billkinddev/jarvis-intercom/guide/finished-build.jpg

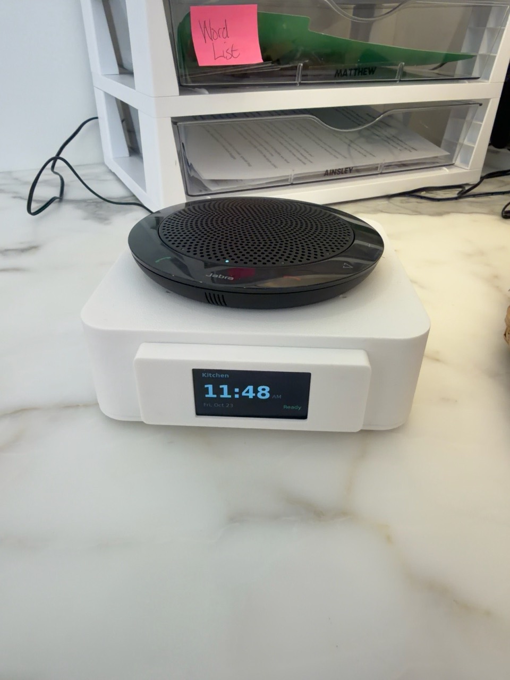
guide/finished-build.jpg
