billkinddev/jarvis-intercom/guide/parts-inventory.png

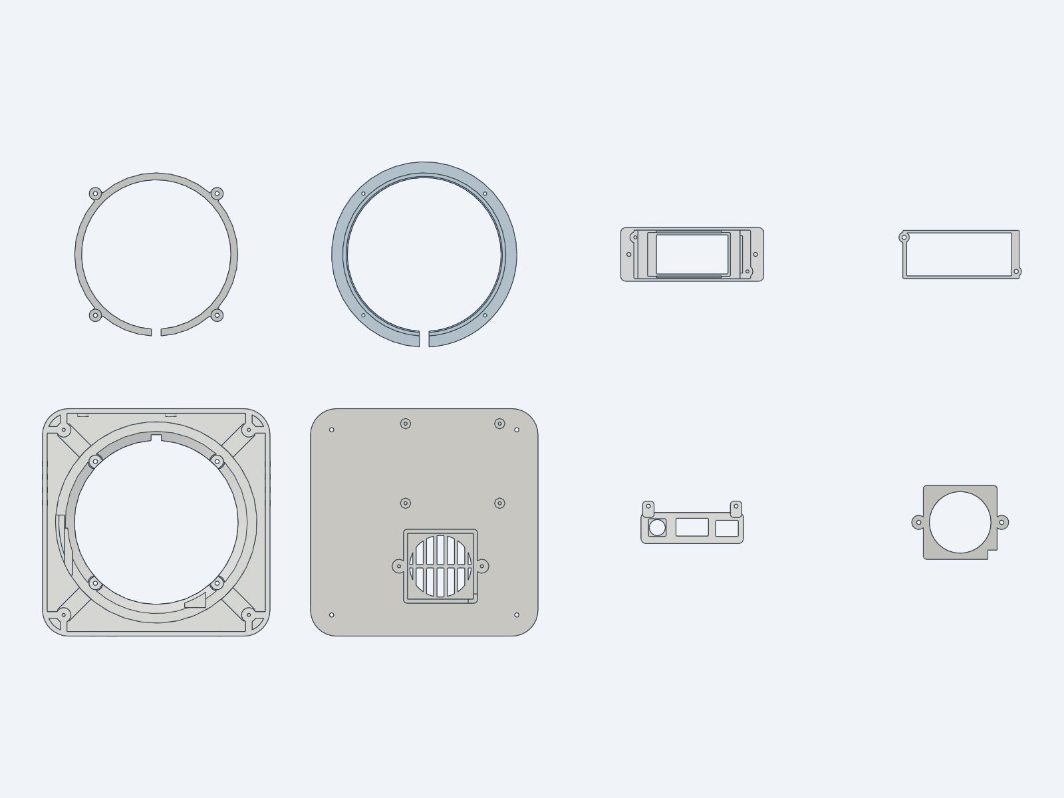
guide/parts-inventory.png
