billkinddev/jarvis-intercom/designs/compact-v3-pi3bplus-r1/STEP/shell.step

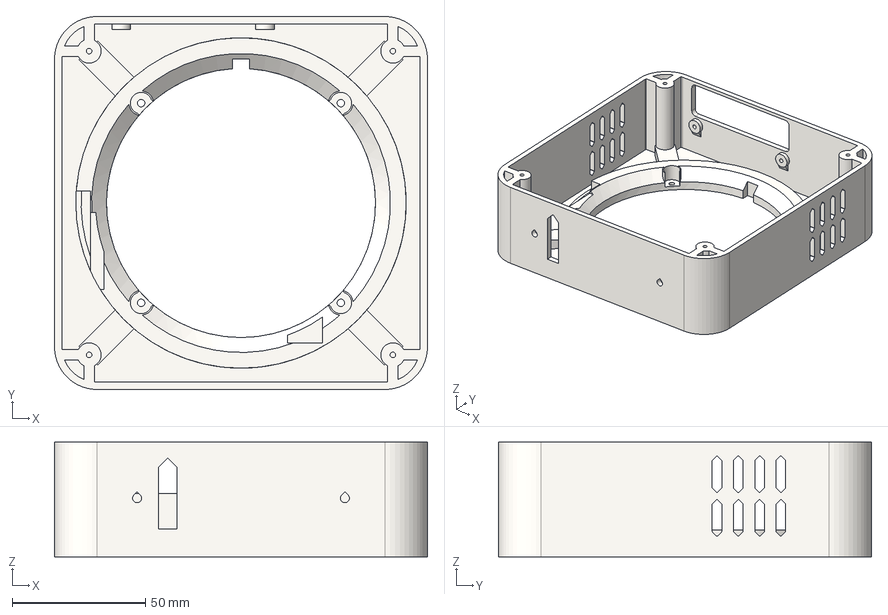
[picture p3: CAD file, 2026-10-23]
designs/compact-v3-pi3bplus-r1/STEP/shell.step
140.0 x 140.0 x 43.0 mm
