billkinddev/jarvis-intercom/designs/compact-v3-pi3bplus-r1/STEP/pi3bplus_rear_insert.step

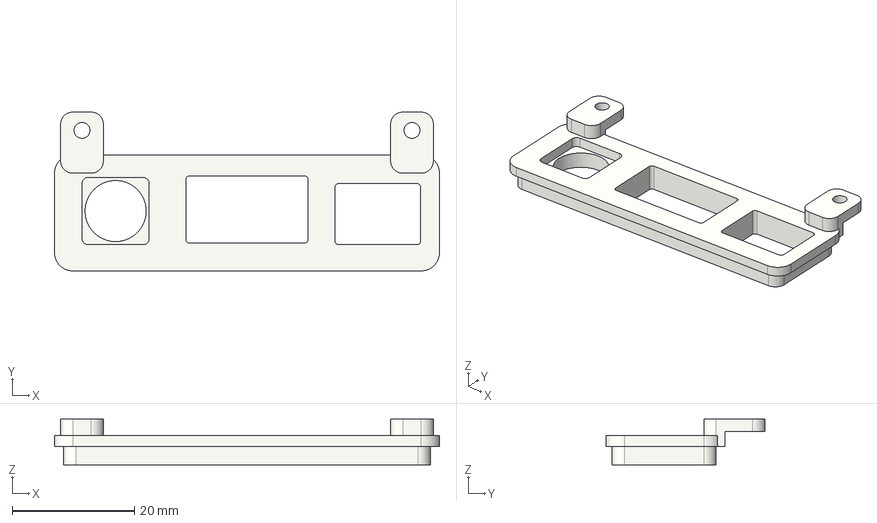
[picture p4: CAD file, 2026-10-23]
designs/compact-v3-pi3bplus-r1/STEP/pi3bplus_rear_insert.step
63.0 x 26.0 x 7.50 mm
