billkinddev/jarvis-intercom/designs/compact-v3-pi3bplus-r1/STEP/base.step

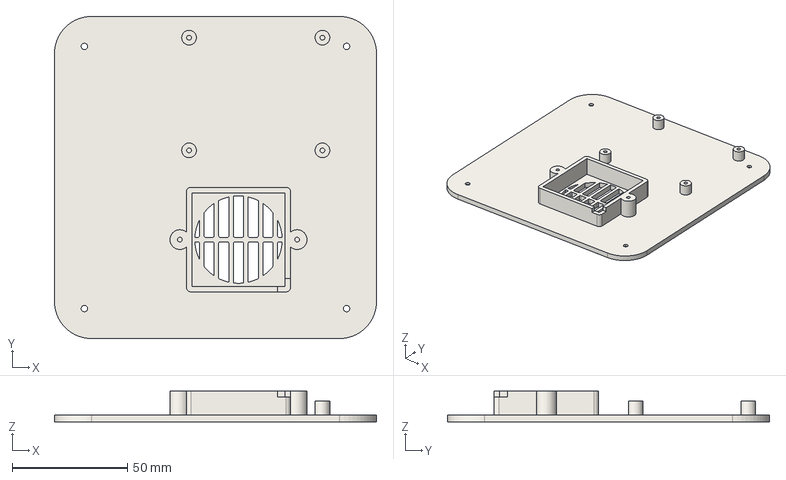
[picture p5: CAD file, 2026-10-23]
designs/compact-v3-pi3bplus-r1/STEP/base.step
140.0 x 140.0 x 13.3 mm
