billkinddev/jarvis-intercom/designs/compact-v3-pi3bplus-r1/STEP/top_ring_2mm_flat_2mm_insertion.step

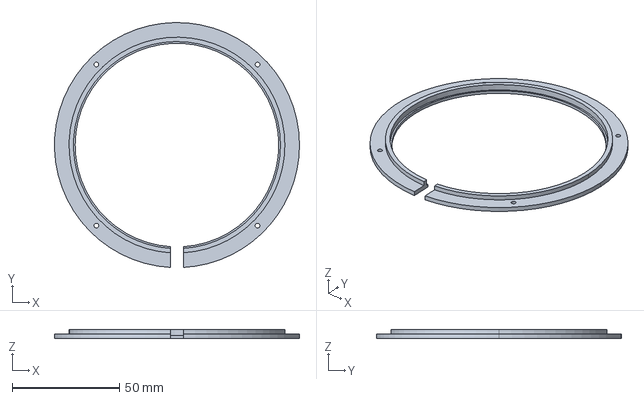
[picture p6: CAD file, 2026-10-23]
designs/compact-v3-pi3bplus-r1/STEP/top_ring_2mm_flat_2mm_insertion.step
114.0 x 113.9 x 4.00 mm
