billkinddev/jarvis-intercom/designs/compact-v3-pi3bplus-r1/STEP/screen_bezel.step

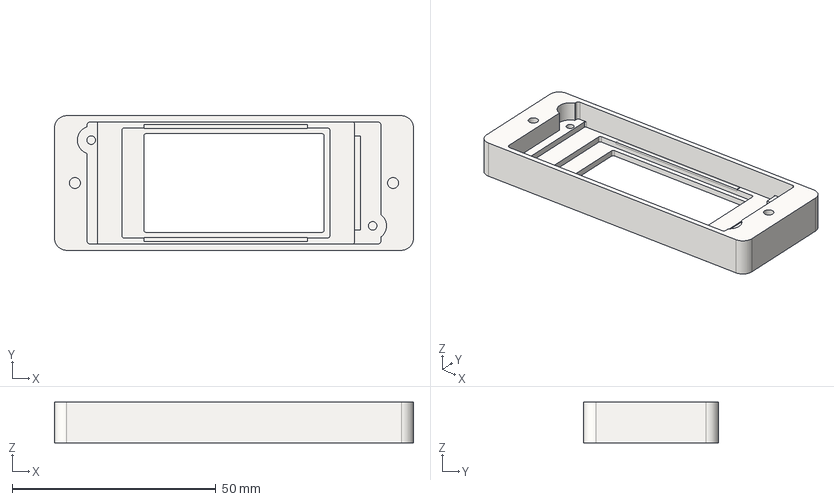
[picture p7: CAD file, 2026-10-23]
designs/compact-v3-pi3bplus-r1/STEP/screen_bezel.step
88.0 x 33.0 x 10.0 mm
