billkinddev/jarvis-intercom/designs/compact-v3-pi3bplus-r1/STEP/lower_jabra_seat.step

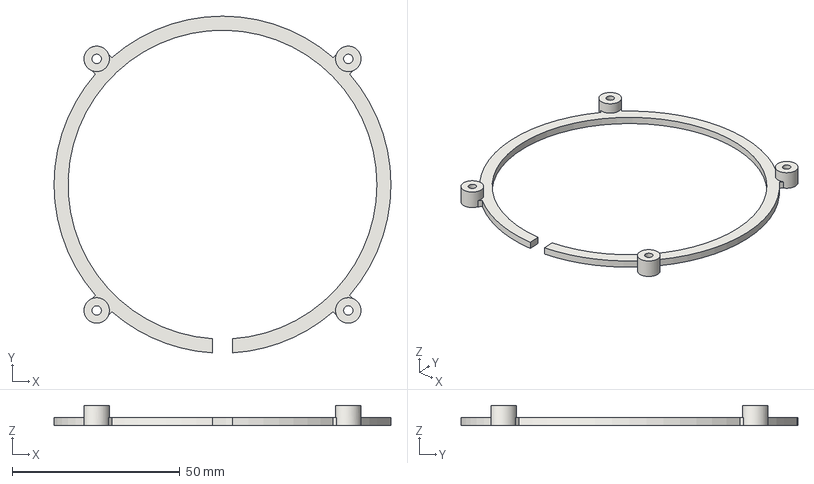
[picture p8: CAD file, 2026-10-23]
designs/compact-v3-pi3bplus-r1/STEP/lower_jabra_seat.step
100.4 x 100.3 x 6.00 mm
