billkinddev/jarvis-intercom/designs/compact-v3-pi3bplus-r1/STEP/screen_retainer.step

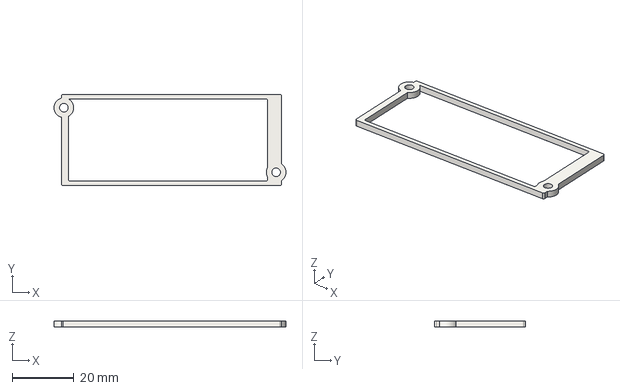
[picture p9: CAD file, 2026-10-23]
designs/compact-v3-pi3bplus-r1/STEP/screen_retainer.step
75.4 x 29.6 x 2.00 mm
