billkinddev/jarvis-intercom/designs/compact-v3-pi3bplus-r1/STEP/fan_retainer.step

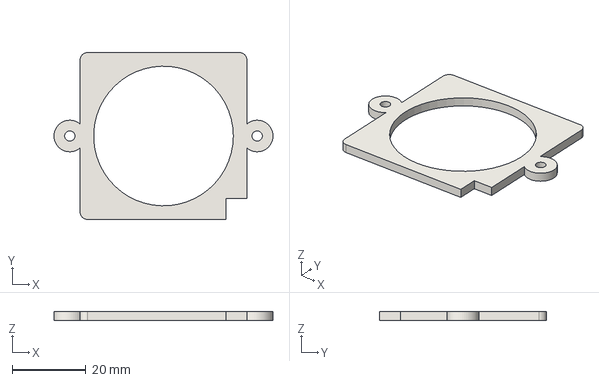
[picture p10: CAD file, 2026-10-23]
designs/compact-v3-pi3bplus-r1/STEP/fan_retainer.step
59.6 x 45.4 x 2.40 mm
