billkinddev/jarvis-intercom/(list of files, cad)

Other CAD files:
designs/compact-v3-pi3bplus-r1/STL/base.stl
designs/compact-v3-pi3bplus-r1/STL/fan_retainer.stl
designs/compact-v3-pi3bplus-r1/STL/lower_jabra_seat.stl
designs/compact-v3-pi3bplus-r1/STL/pi3bplus_rear_insert.stl
designs/compact-v3-pi3bplus-r1/STL/screen_bezel.stl
designs/compact-v3-pi3bplus-r1/STL/screen_retainer.stl
designs/compact-v3-pi3bplus-r1/STL/shell.stl
designs/compact-v3-pi3bplus-r1/STL/top_ring_2mm_flat_2mm_insertion.stl
