billkinddev/jarvis-intercom/guide/index.html

Jarvis Intercom / Build notesCompact v3 · October 2026

A DIY room-to-room intercom

# Jarvis Intercom.

“Hey Jarvis, call the office.”
A Raspberry Pi, a proper speakerphone, and a case built around everyday use.

Local wake + command recognitionSIP calling3D-printed enclosure

Explore in 3D ↘Get the design files

Jarvis Intercom, built and running. Actual photo of the finished Kitchen station.

140 × 140 mmMain enclosure footprint

46 mmBody height; excludes Jabra, bezel and pads

8 printed partsMatched Pi 3 B+ reference kit

1.9″ status displayClock, room and call state; no touch

01 / What it does

## A small intercom for the house.

Say the wake phrase, wait for the beep, then ask to call a room. Or press the Jabra’s green button to start a command. Incoming calls can ring for an answer or connect automatically, with an optional arrival chime. The screen shows the time and who the station is calling.

The useful shortcut

### Keep the conference speakerphone.

The Jabra provides the microphone, speaker, buttons and audio processing in one USB device. We kept those strengths and built a smaller, serviceable enclosure around the Pi and display.

### Built for calling

Local wake detection and a small call vocabulary keep the interaction focused. The current build is an intercom, not a general conversational assistant. There is no cloud speech-recognition dependency for the wake phrase or room commands.

What this page shares: the working system’s design approach, the frozen Pi 3 B+ geometry set, wiring and reference settings. The application is still a private project; there is no public one-click installer or ready-made SD image in this download.

02 / Hardware

## The parts inside.

This reference version uses a Pi 3 B+. A Pi 4 station also exists, but its power connector and rear insert differ. Use the matching geometry for the board you actually have.

Part | Quantity | Reference build / purpose
Raspberry Pi 3 Model B+ | 1 | 1 GB RAM, Wi-Fi, full 40-pin header. Runs headless with Raspberry Pi OS Lite 64-bit.
Jabra Speak 410 USB speakerphone | 1 | Connected by USB inside the enclosure. Confirmed audio/control model; similar-looking Jabra models are not automatically interchangeable.
1.9-inch ST7789 IPS module | 1 | 170 × 320 pixels, 8-pin SPI, labels GND / VCC / SCL / SDA / RES / DC / CS / BLK. Status display, not a touchscreen.
GeeekPi / 52Pi F-0011 fan | 1 | 5 V, 40 × 40 × 10 mm, red power / black ground / blue control. Fits the base pocket with a printed retainer.
MicroSD card | 1 | 32 GB class used for the reference setup.
Micro-USB power supply | 1 | Quality regulated supply. The official Pi 3 supply is 5.1 V / 2.5 A. A 5 V / 1 A adapter is undersized for this combined build.
Female-to-female jumper leads | 8 | For the display; the fan has its own three leads. Leave enough slack to open the base.
Heatsink, rubber pads, fasteners | 1 set | Low-profile Pi heatsink with clearance; pads that leave roughly 6–8 mm underneath; joint-specific screws below.
Printed kit | 8 parts | White PLA reference prints. Individual STL and STEP files are bundled below.
Shared call server | 1 per system | A separate always-on Linux machine runs Asterisk. The reference system uses a Pi 5 for central services.

Hardware references: Pi 3 B+ (https://www.raspberrypi.com/products/raspberry-pi-3-model-b-plus/) · Official power supply (https://www.raspberrypi.com/products/micro-usb-power-supply/) · F-0011 fan specification (https://wiki.52pi.com/index.php?title=F-0011).

Fastener list and where each screw goes

Joint | Hardware | Direction / receiving feature
Base to shell | 4 × M2.3 × 12 mm self-tapping | From underside through recessed head seats into shell pilots. No nuts.
Pi to base | 4 × M2.3 × 6 mm self-tapping | Through PCB mounting holes into printed pilots. Snug by hand.
Fan retainer | 2 × M2.3 × 8 mm self-tapping | Through the retainer into pocket posts, outside the fan housing.
Rear insert | 2 × M2.3 × 6 mm self-tapping | From inside the empty shell.
Screen retaining frame | 2 × M2.5 × 6 mm | From rear frame into bezel. Do not substitute 8 mm screws; front skin is thin.
Bezel to shell | 2 × M3 × 10 mm | From inside the shell into the bezel.
Thin top ring / lower seat | 4 matching screws; length still to verify | The 2 mm ring changes engagement. The old thicker-collar M2.5 × 12 mm length is not a specification for this ring.

The ring’s screw length is the remaining gap in the frozen kit’s hardware record. Check actual engagement and clearance before tightening; do not force an inherited screw length into the thin ring.

03 / The matched design

## Explore the build in 3D.

Rotate the assembly, slide the pieces apart, or hide the shell to see inside. Choose “Only this” to inspect one piece. The eight printed meshes match the downloadable kit; hardware is illustrated with simplified shapes.

EXPLORE THE DESIGN

### Every piece, inside and out.

Perspective view

Drag to rotate · Scroll or pinch to zoom · Arrow keys rotate

All pieces are hidden.

Show all pieces

Explore

Exploded assemblySeparation 0%Open assemblyCutaway (visual only)Show hardware

Cut axis Cut position

Viewpoint

FrontRearLeftRightTopBottomReset

Zoom +Zoom −

## Pieces

Show all

Uncheck to hide. Choose Only this to inspect a piece on its own.

Hardware & cables

Key dimensions

CAD pieces use the supplied design meshes. Hardware, if shown, represents approximate envelopes. Cutaway and exploded motion explain the assembly; they do not verify physical fit or collision clearance.

Compact enclosure v3 / Pi 3 B+ / flat 2 mm ring / r1. The thin ring is shown in its nominal position on the top deck; the viewer does not establish screw engagement or clearance.

See the flat inventory of all eight printed pieces

Show complete kit

Orthographic inventory view, not an assembled model or a ready-to-print plate. Units: millimeters.

Reference kit

### One of each.

The shell, base, speaker retention, screen mount and board-specific rear insert stay together as a matched revision.

1Shell2Base3Pi 3 B+ rear insert4Fan retainer5Lower Jabra seat6Flat 2 mm top ring7Screen bezel8Screen retainer

### Keep the Jabra exposed

The flat ring has a 2 mm flange and a further 2 mm insertion wall. A single cable split routes the cord. The speakerphone’s top, touch controls and side openings remain exposed.

### Make the base serviceable

The 40 mm fan sits ahead of the Pi in a 40.6 mm pocket. A separate bracket retains its housing. The removable rear insert matches the Pi 3’s micro-USB, full-size HDMI and audio sockets.

04 / Print settings

## Orient for the finish. Support selectively.

The reference prints used white PLA, 0.4 mm nozzles and 0.20 mm layers. The shell printed on a Snapmaker U1; base and small-part work used a FlashForge Adventurer 5M Pro. These are recorded settings, not G-code for another printer.

Part / recorded job | Orientation | Walls / infill | Support / adhesion
v3 shell | Cosmetic top face on the bed | 4 walls; 25% grid | Manual support beneath the rear opening roof. No support filling the Jabra center, vents or screw holes. No brim in the Oct 19 job.
Base + fan retainer | Base underside down; fan pocket walls upward. Retainer flat. | 4 walls; 25% grid | No supports and no brim in the recorded Oct 19 toolpath.
Selected flat top ring | Flat flange on the bed | 4 walls; 15% grid | No supports. 3 mm outer brim, 0.1 mm separation in the actual Oct 20 G-code.
Rear insert + screen parts + lower seat | Retain exported orientations; inspect in slicer | 0.20 mm / 4 walls as a starting point | Local insert flange / ear support may be required. Inspect screen locating features and keep terminals, pilots and accessible faces clear.

Recorded temperatures, speeds and time estimates

Shell: 220°C nozzle / 60°C bed; 0.24 mm first layer, five top and ten bottom layers; 0.20 mm support Z gap, 0.35 mm XY gap; rear seam. First-layer walls 50 mm/s, infill 105 mm/s. Outer-wall preset 200 mm/s. The saved shell + older Pi 4 insert job estimated 4h 25m / 160 g, so that is not an exact Pi 3 full-kit time.

Base + fan retainer: 220°C nozzle; bed 60°C first layer, then 55°C; 0.20 mm first layer; five top / three bottom layers; first-layer walls 20 mm/s, infill 30 mm/s. Saved estimate 2h 46m / 57.7 g.

Ring: 220°C nozzle; bed 60°C first, then 55°C; first-layer walls and infill 20 mm/s; initial acceleration 300 mm/s². The recorded 39-minute job contained two trial rings, not one final ring.

About surface lines: these saved jobs did not use a special slow outer-wall profile. A slower exterior is a tuning experiment, not an already-proven setting here. Start from your printer’s calibrated profile and compare a short sample before repeating the full shell.

A later two-printer batch was prepared but not printed. Its revised screen bezel and slice estimates are not treated as build validation. The download contains unsliced geometry only.

Preview the toolpaths around the actual features. Earlier automatic supports clogged nut pockets and left exterior scars. The newer base avoids those nut traps, and supports on the shell are confined to accessible, mostly hidden areas. This is not a claim that every part prints without support.

05 / Assembly

## Build from the open shell outward.

Disconnect power before fitting the electronics or changing wiring. Check fit without screw pressure first. The checks below are session notes for the builder, not automatic verification.

0 of 6 checks markedReset checks

STEP 01

### Clean and identify the printed parts

Remove brim and the deliberately placed rear-opening supports. Check the pilots, grille and port openings. Match all eight parts to the kit above, including the Pi 3 rear insert and the flat 2 mm ring.

Do a dry fit of the base and rear insert before installing electronics. Avoid twisting fragile locating features while removing support.

Parts match and mating surfaces are clear.

STEP 02

### Fit the rear insert and display

In the empty shell, install the board-specific rear insert. Seat the ST7789 in the front bezel; fit the rear retaining frame at the PCB edges. Attach the bezel from inside the shell.

If the header end sits high, stop. Do not use the screws to pull it flat. A later pin-clearance bezel revision is still fit-pending and is not silently substituted into this frozen download.

Screen sits flat with clearance for pins and solder joints.

STEP 03

### Seat the Jabra and align the cable split

Align the Jabra cord with the split in the top ring and lower seat. Keep the side openings and buttons clear. Use the four retention positions, checking actual screw engagement for this thinner ring.

The old thicker-collar screw length has not been validated for this ring. Confirm that detail before closing the build.

Jabra is secure without pressure on its controls or cord.

STEP 04

### Mount the fan and Pi on the base

Point the fan’s airflow arrow upward into the enclosure. Route its wires through the corner exit and fit the retainer without bending the housing. Mount the Pi with its power, HDMI and audio sockets facing the rear insert; USB-A/Ethernet face inward.

Fan blades turn freely; board and rear ports line up.

STEP 05

### Connect and bench-test

Plug the Jabra into USB-A. Connect the display and fan using the interactive map below. Leave service slack for opening the base; route it away from blades, screw posts and the closing seam.

With the base accessible, power on and confirm the screen, USB audio and software readiness. A stopped temperature-controlled fan is normal below its threshold.

Wiring checked at both ends and powered functions tested.

STEP 06

### Close, raise and test in the room

Shut down and unplug again. Close the base with its four recessed screws. Place rubber pads near the corners, leaving both the intake and closure screws accessible.

Test wake detection at the usual distance, two-way calls, repeated green/red/mute use and a restart. Compare fan noise and temperatures in the actual enclosure.

Clear intake, no trapped cables, room test completed.

06 / Wiring

## Eleven connections. One at a time.

The diagram uses physical header pin numbers, with the Pi viewed from the component side. GPIO18 is physical pin 12. Match display labels rather than guessing from jumper color.

REFERENCE WIRING · PI 3 B+

### Connect the status screen and controlled fan

1.9-inch ST7789, 170 × 320 pixels · GeeekPi F-0011 5 V fan

Shut down the Pi, then unplug its power before wiring.
Every number below is a physical header pin. The display uses 3.3 V only; never connect its VCC or BLK to 5 V.

#### 1. Turn the Pi this way

Components facing you. GPIO header at the top. USB and Ethernet ports on the right. Pin 1 is at the left end, on the inner row nearest the board’s components.

Schematic, not to scale. The highlighted line shows the selected electrical connection, not how to route the cable.

#### 2. Connect one wire at a time

11 connections

DISPLAY LABEL KEY · match the lettering printed on your screen

FAN WIRES · F-0011 only

← PreviousNext →

The selector above is a label key, not a physical connector drawing. The module used here has the front/back orders below. Verify the labels on your exact module; jumper colors may differ.

Display front

Screen facing you, header along the top. Left → right:

GND · VCC · SCL · SDA · RES · DC · CS · BLK

Display back

PCB facing you, header still along the top. Left → right:

BLK · CS · DC · RES · SDA · SCL · VCC · GND

Temperature control is a software setting. The reference build uses physical pin 12 (BCM18) for the F-0011 control lead. A quieter Pi 3 B+ trial uses 70°C on and below 60°C off; this is not a universal fan default. Keep the Pi’s firmware thermal protections. Wiring alone does not enable control.

Complete wiring table

Connection | Physical pin | Function

No pins are shared. Keep the fan’s 5 V power separate from the display’s 3.3 V power. GPIO18 is a fan control signal, not fan power.

Before reconnecting power

Check each connector against the table. Make sure no plug is shifted over by one pin or bridging two pins. Confirm the display’s VCC is on pin 1 and BLK is on pin 17.

The Jabra connects to a normal USB port. Leave the fan blades and airflow path clear. Then reconnect power and check the screen; software status alone cannot prove the display or fan works.

Reference wiring checked October 23, 2026. This map matches the documented Pi 3 B+ SPI configuration.
References: Raspberry Pi GPIO documentation (https://www.raspberrypi.com/documentation/computers/raspberry-pi.html#gpio-and-the-40-pin-header) · 52Pi F-0011 (https://wiki.52pi.com/index.php?title=F-0011). The fan manufacturer’s wiring image conflicts with its GPIO18 setup instructions; this guide consistently assigns control to physical pin 12.

07 / How the software works

## Local ears. A shared switchboard.

Established audio and calling components do the heavy lifting. Small native services connect them, expose health and settings, and drive the screen.

Room stationJabra → ALSA
openWakeWord → Vosk
Baresip SIP client

↔

Local switchboardAsterisk
Room routing, ringing,
drop-in policy and chime

↔

Other room / phoneAnother station
or a SIP client
such as Linphone

### The station

Raspberry Pi OS Lite runs Baresip, the Python listener, a status-display service and a separate reporter. ALSA dsnoop and dmix share the Jabra between calling and recognition. The Pi station uses native services rather than a desktop browser or Docker.

openWakeWord detects “Hey Jarvis.” Silero VAD helps reject non-speech. After the beep, local Vosk recognition checks a constrained room vocabulary. A recognized call dials directly without an extra spoken “Calling…” announcement.

### The management panel

The manager uses Python and SQLite behind private Tailscale HTTPS access. Stations check in about every five seconds when controls are enabled. The heartbeat response carries wake preferences and one-time volume/shutdown requests; the UI waits for acknowledgement.

Incoming call mode follows a separate path: the manager publishes a small policy file read by Asterisk for each new call. The current Asterisk server runs in Docker. Calling needs the switchboard, but not the management page to stay open.

How we provisioned the working system

1. Flashed Raspberry Pi OS Lite 64-bit to the SD card, with a unique hostname, SSH identity, Wi-Fi profile and timezone. The Pi 3 B+ reference used Trixie and Python 3.13.
2. Bench-tested USB audio, then installed ALSA, Baresip, Python environments and SPI/GPIO dependencies. Enabled SPI for the display.
3. Created station identities and room routes on the local Asterisk switchboard. Restricted inbound station SIP to the trusted server.
4. Installed pinned wake/Vosk dependencies and hash-checked model files. The wake model is hey_jarvis_v0.1.onnx. Bounded room grammar and alias matching reject unknown destinations and self-calls.
5. Installed the independent display and reporter, thermal collection, saved network recovery and safe-shutdown handling. Verified fresh capture and call-control state, not only running processes.
6. Enrolled each reporter with its own credential and restricted Tailscale policy. In this build station tailnet access is limited to manager HTTPS; call audio uses the LAN. Remote-room SIP routing is a separate network configuration.
7. Configured fan control after checking the exact three-wire fan. Screen operation and fan response were confirmed on the Pi 3 B+ reference. Two-way room/phone calls and repeated button cycles were exercised across existing stations; each new assembly still needs its own call acceptance test.

This is the build sequence, not an install script. The private project still has deployment-specific paths and room configuration. The download below includes mechanical files and public reference settings, not credentials, a preconfigured OS image, trained models or the application runtime.

Privacy and phone behavior

Wake and call-command recognition run locally. Normal operation does not save raw microphone recordings or send speech to cloud recognition. During calls, voice travels through the switchboard to the other endpoint. The manager receives metadata, not recordings or transcripts.

Recognized command text does appear in local service logs. Turning wake-word listening off does not electrically mute the microphone: capture continues for button commands and calls. Jabra’s native mute is the microphone control, and call transitions can change its state.

A phone can join with its own SIP account in Linphone. Reliable background ringing on a suspended iPhone app is not solved by simply installing a SIP client. Our custom notification workaround is not a universal native VoIP push solution.

08 / Settings

## What you can change today.

Management controls are per station. Hardware inventory and enclosure references remain visible while a device is offline. Saved or queued settings are distinguished from values acknowledged by the device.

Control | Behavior | Where
Wake word | On / off. Off still permits green-button commands and calls; it is not microphone mute. | Management UI
Speaker volume | 0–100%, rounded to hardware steps. Physical Jabra buttons remain effective; readback is separate. | UI + Jabra
Incoming call mode | Ring and answer, or automatic drop-in. Unknown/missing policy falls back to ringing. | Management UI
Arrival chime | Optional short two-note sound before a drop-in conversation is bridged. | Management UI
Microphone mute | Standard Jabra control. No backend mute/unmute override. Check its state at call transitions. | Jabra button
Shutdown | Confirmed, one-time Pi shutdown while idle. Physical power cycle is needed to turn it on again. | Management UI
Temperature and health | CPU temperature, firmware power/throttle flags, capture/call readiness, release and service status. Snapshot, not a temperature history. | UI readout
Room names and aliases | Several spoken names may reach one destination. Maintained in configuration and deployed, not yet edited in the UI. | Configuration
Quiet hours / scheduled DND | Planned. Intended to block incoming calls and automatic sounds while permitting deliberate outgoing calls. | Not implemented

### Fan: prioritize a quieter room

The Pi 3 B+ reference turns the fan on at 70°C and off below 60°C. Hysteresis prevents rapid cycling. This is native kernel on/off control, not a continuously variable fan curve or management slider.

dtoverlay=gpio-fan,gpiopin=18,temp=70000,hyst=10000

Copy fan setting

One entry under [all] in /boot/firmware/config.txt, after wiring is verified. Fresh setup needs the overlay loaded at boot; back up the file first and coordinate a restart. Do not add a second conflicting fan overlay.

Firmware protection remains enabled. Pi 3 B+ can reduce its clock at its default 60°C soft limit, so this choice trades some peak speed for less fan time. It is a reference trial, not a universal optimum.

### Display: a separate status service

SPI0 CE0, 8 MHz; logical canvas 320 × 170; column offset 0, row offset 35. Set rotation 0 or 180 for the mounting. The reference build uses 180.

The service updates call state every half second and the clock once per minute. Stale call metadata clears after five seconds. A reset-before-initialization fix was needed with ST7789 library 1.0.1.

BLK is tied to 3.3 V here. That provides a constant backlight; drawing black does not switch the light off. This display has no touch interface.

Wake and command tuning values

Documented starting values, not sliders in the UI. Idle input uses 16 kHz mono audio and 80 ms frames. VAD helps with non-speech; it cannot know whether TV speech was meant for the device.

{
  "wake_threshold": 0.7,
  "wake_trigger_frames": 2,
  "wake_vad_threshold": 0.5,
  "wake_threshold_call": 0.25,
  "wake_trigger_frames_call": 1,
  "wake_refractory_seconds": 2.0,
  "listen_seconds": 8,
  "playback_cooldown_seconds": 0.16
}

Copy reference values

Two consecutive idle scores must qualify. During a call, only call-ending commands are accepted; the in-call path uses its own threshold because speakerphone processing can attenuate input. Ordinary destination recognition also checks Vosk word confidence against 0.85. Retest at the intended distance and in the actual room before changing sensitivity.

Temperature observations, with their limits

The Pi 3 B+ reference was checked after a restart on October 21: approximately 58°C, fan commanded off, firmware flags 0x0, and healthy listener/display/intercom/reporting services. Another Pi 4 station running without its fan sampled roughly 65–67°C without recorded power or throttle flags at that check.

These were short observations, not a continuous thermal soak or a guarantee for every case. The physical fan’s on/off response was confirmed, while longer-term duty cycle and responsiveness with the 70/60 policy still need normal-use observation. Keep the bottom intake raised and compare actual temperatures before deciding whether a different build needs a fan.

09 / What changed along the way

## The useful lessons came from building it.

### Support was a design problem

Automatic support filled nut pockets, broke a holder during removal and marked the outside. Accessible support regions and simpler screw joints mattered more than cleanup tools.

### Expose the audio hardware

The early high lip buried the Jabra. The lower, flat ring leaves its controls and side openings exposed. Evaluate pickup and echo with the complete case assembled.

### Use the native controls

Trying to override microphone mute remotely made state handling harder. The working approach uses the Jabra’s standard controls, with wake enablement as a separate setting.

### Record the exact build

Different board ports, ring thicknesses and fan sizes created similar-looking variants. A frozen part set and per-device design record prevent guessing which files belong together.

Two practical details saved time: the front labels on the display are mirrored when you view its rear pins, and rubber pads are part of the cooling design. A fan pressed against the tabletop cannot use its intended intake path.

10 / Files and references

## A matched kit to inspect and adapt.

The download contains eight original STLs, eight editable STEP solids, public build notes, reference settings and SHA-256 checksums. Models are in millimeters. Select and arrange parts in your own slicer; this is not printer-ready G-code.

### Compact v3 · Pi 3 B+ · 2 mm flat ring · r1

Original geometry preserved. Old collars, alternate rings, the Pi 4 insert, vendor reference boards, machine logs and credentials are excluded.

GitHub repository ↗ (https://github.com/billkinddev/jarvis-intercom)Download release ↗ (https://github.com/billkinddev/jarvis-intercom/releases/tag/compact-v3-pi3bplus-r1)

ZIP · 1.48 MB · 16 geometry files + public reference documents

The files and revision history live on GitHub. Open the release page and choose the STL + STEP ZIP under Assets, or browse individual parts in the repository.

In this Whamlink preview, select a link to reveal its address, then copy it into a new tab.

What is verified, and what still needs checking

- The selected 2 mm ring was physically preferred in fit testing. The download is an exact matched frozen geometry selection, not a claim that every installed station uses identical hashes.
- Fan response, display operation and intercom behavior have been exercised on reference stations. Each new assembly still needs its own audio, wiring and thermal check.
- The thin ring’s final screw length and the original bezel’s fit around a particular display’s soldered header need checking. An optional pin-relief bezel revision remains fit-pending and is not included.
- Application code, model files and an SD image are not included. There is not yet a public universal software release.

### Built on established projects

Project-specific behavior above comes from this build’s source and verification records. Select a reference to reveal its address, then copy it into a new tab. These references document the upstream components and hardware.

openWakeWord (https://github.com/dscripka/openWakeWord/tree/v0.6.0)Vosk (https://alphacephei.com/vosk/)Baresip (https://github.com/baresip/baresip)Asterisk (https://www.asterisk.org/)Raspberry Pi OS (https://www.raspberrypi.com/software/)Pi thermal documentation (https://www.raspberrypi.com/documentation/computers/raspberry-pi.html)

Upstream projects and pretrained models have their own licenses. They are linked, not redistributed in the geometry download.

Jarvis Intercom · Build record dated October 23, 2026.
A working home project, with the unfinished details kept visible. This page has no connection to the live management system.
