billkinddev/jarvis-intercom/guide/assembled-preview.png

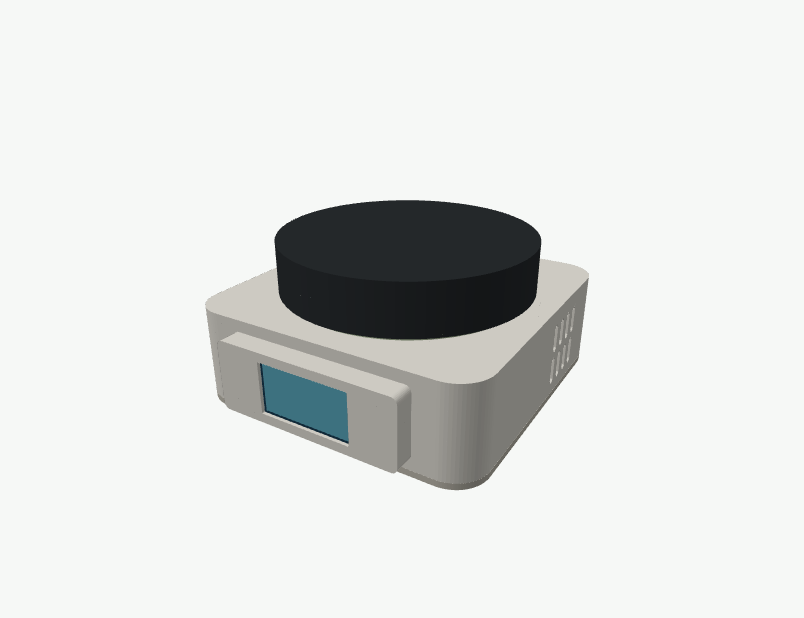
guide/assembled-preview.png
